rkdotxyz/DM2601/presentation/v1/images/persona.png

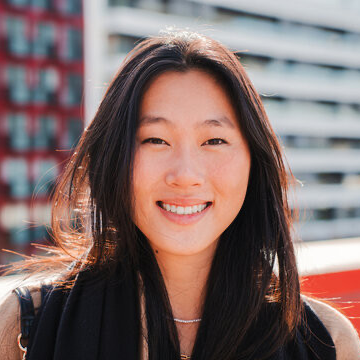
presentation/v1/images/persona.png
