rkdotxyz/DM2601/workbook/README.md

# Workbook

The project workbook for DM2601 will go here as a PDF once it's ready.

It documents the process behind the [presentation](../presentation) and the [prototype](../prototype): research, analysis, ideation and the build.
