rkdotxyz/DM2601/prototype/firmware/heart_doll/heart_doll.ino

/*
  heart_doll.ino  -  Heart Doll firmware (v1.2: its own WiFi, the 3D app)

  A doll with an RGB heart and two buttons:
    Heart  -> tells the phone "I'm available";   heart breathes slowly
    Cross  -> tells the phone "I'm busy";        heart goes dark
  and a phone person who can say Available (heartbeat) or Unavailable.
  Phone available on its own: heartbeat at 60%. Both available, in
  either order: heartbeat at 100%. Each person stays available until
  they change it themselves; Cross means "not now".

  How the files fit together
  --------------------------
    config.h          every setting
    state_machine.h   the rules: (state, event) -> next state
    led.h             draws patterns on the LED
    buttons.h         debounced button presses
    app_link.h        the doll's WiFi, the web server and the WebSocket
    web_page.h        the phone app, built from prototype/app (generated)
    secrets.h         your WiFi name and password (never committed)
    secrets.example.h template: copy it to secrets.h and fill it in
    heart_doll.ino    this file: turns inputs into events, applies the
                      rules, and carries out the effects

  The ESP32 holds the one true state. The phone only sends requests
  and shows what the doll reports back.
*/

#include "config.h"
#include "state_machine.h"
#include "led.h"
#include "buttons.h"
#include "app_link.h"

// The single source of truth.
DollState state = STATE_IDLE;

// Is a phone here, with the app open? And since when has it been gone
// (0 while a phone has it open)?
bool          phoneHere        = false;
unsigned long phoneGoneSinceMs = 0;


// ---------------------------------------------------------------------
// Effects: what each state looks like, and what the phone is told
// ---------------------------------------------------------------------

// Each state has exactly one LED pattern. While no phone is here, the LED
// shows the state as if the phone person had stepped away (the rules
// themselves say what that is): their heartbeat goes, and only the doll
// person's own breathing is left. The state itself is kept, so a phone
// that's back within PHONE_GONE_MS picks up where it left off.
void showState(DollState s) {
  if (!phoneHere) s = nextState(s, EVENT_APP_UNAVAILABLE);
  switch (s) {
    case STATE_IDLE:      ledSetPattern(PATTERN_OFF);       break;
    case STATE_WAITING:   ledSetPattern(PATTERN_BREATHING); break;
    case STATE_CONNECTED: ledSetPattern(PATTERN_HEARTBEAT_SOFT); break;
    case STATE_DECLINED:  ledSetPattern(PATTERN_OFF);            break;
    case STATE_TOGETHER:  ledSetPattern(PATTERN_HEARTBEAT_FULL); break;
  }
}

// Tell the phone the current state, e.g. "status:waiting".
// Sent on every change (and, from Phase 3, whenever a phone connects).
void sendStatus() {
  char message[32];
  snprintf(message, sizeof(message), "status:%s", stateName(state));
  appLinkSend(message);
}


// ---------------------------------------------------------------------
// The one place where events are handled
// ---------------------------------------------------------------------
void handleEvent(DollEvent event) {
  DollState before = state;
  DollState after  = nextState(before, event);   // the rules decide

  // Log it: "[HEART button] idle -> waiting"
  Serial.print("[");
  Serial.print(eventName(event));
  Serial.print("] ");
  Serial.print(stateName(before));
  Serial.print(" -> ");
  Serial.print(stateName(after));
  Serial.println(after == before ? "  (no change)" : "");

  // Button presses are also one-off EVENTS for the phone (it shows a
  // banner), and they get the acknowledgement flash, even when the
  // state doesn't change: pressing Heart twice re-sends "available".
  if (event == EVENT_HEART) {
    appLinkSend("event:heart");
    ledFlash();
  } else if (event == EVENT_CROSS) {
    appLinkSend("event:cross");
    ledFlash();
  }

  // Only a real change updates the LED and the phone's status.
  if (after != before) {
    state = after;
    showState(state);
    sendStatus();
  }
}


// ---------------------------------------------------------------------
// Is a phone here?
// ---------------------------------------------------------------------
// Blue blink while no phone has the app open, and no heartbeat for a phone
// person who isn't there (see showState()). If no phone has been back for
// PHONE_GONE_MS, they've gone for good: that counts as stepping away, and
// the state changes too. Shorter gaps (a reload, a locked screen) only
// change the LED until the phone is back.
void checkPhone(unsigned long now) {
  bool here = appLinkOnline() && appLinkPhones() > 0;
  if (here != phoneHere) {
    phoneHere = here;
    Serial.println(here ? "A phone has the app open." : "No phone has the app open.");
    showState(state);   // with or without the phone person's heartbeat
  }
  ledSetNoPhone(!phoneHere);

  if (phoneHere) {
    phoneGoneSinceMs = 0;
    return;
  }
  if (phoneGoneSinceMs == 0) phoneGoneSinceMs = now ? now : 1;

  bool phonePersonAvailable = (state == STATE_CONNECTED || state == STATE_DECLINED ||
                               state == STATE_TOGETHER);
  if (phonePersonAvailable && now - phoneGoneSinceMs >= PHONE_GONE_MS) {
    Serial.println("No phone for a minute: the phone person has stepped away.");
    handleEvent(EVENT_APP_UNAVAILABLE);
  }
}


// ---------------------------------------------------------------------
// setup() and loop()
// ---------------------------------------------------------------------
void setup() {
  Serial.begin(SERIAL_BAUD);
  delay(500);   // only here: let the USB serial connect

  Serial.println();
  Serial.println("=== Heart Doll v1.2 - its own WiFi ===");

  ledBegin();
  if (BOOT_COLOUR_CHECK) ledColourCheck();
  buttonsBegin();
  appLinkBegin();

  showState(state);
  sendStatus();
}

void loop() {
  unsigned long now = millis();

  // 1. Inputs become events. Nothing here ever waits.
  if (buttonPressed(BUTTON_HEART, now)) handleEvent(EVENT_HEART);
  if (buttonPressed(BUTTON_CROSS, now)) handleEvent(EVENT_CROSS);

  int fromPhone = appLinkReadEvent();
  if (fromPhone >= 0) handleEvent((DollEvent)fromPhone);

  // 2. Network housekeeping (never waits).
  appLinkUpdate(now);
  checkPhone(now);

  // 3. Output: redraw the LED when it's time.
  ledUpdate(now);
}
