rkdotxyz/DM2601/(commit log)

2026-09-15 Build out presentation deck and split into separate files
    Move the deck from a single inline-styled HTML file into index.html,
    styles.css and script.js so the markup stays readable as slides grow.
    Slide work:
    - Add Habit/Routine/Ritual framing slide with comparison table
    - Split target user group into exploring and finalizing slides, using
    scattered notes that narrow to a single focus
    - Add high level ritual domain slide where the decision not to commit to
    a ritual occupies the centre, in place of a chosen one
    - Add persona slide for Marie
    - Drop the agenda slide and the per-slide section numbering
    Slides now cut instantly rather than animate. The one exception is the
    target user group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
2026-09-15 Add research slides and three design directions
    Fill out the middle of the deck with the actual study material and carry
    it through to the directions it produced.
    New slides:
    - Literature review, twelve papers with titles resolved from their DOIs
    - Research findings, thirty observations scattered as a wall of notes
    - Affinity diagramming, those notes clustered into eight themes
    - Three directions to take, plus a scenario, point of view and how might
    we slide for each of phone usage, media consumption and social
    interaction
    The five themes we are not pursuing are muted on the affinity slide so
    the three live ones carry the eye, and those three keep the same order
    everywhere they appear.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
2026-09-15 Trace the double diamond as a progress indicator
    The project is about the double diamond, so the deck now shows where it
    sits in one. A small glyph in the top right carries a grey track with a
    dark line drawn over it, advancing slide by slide.
    Both the upper and lower edges draw at once, so the line visibly spreads
    apart while the work diverges and closes as it converges. It stops just
    short of the waist and holds there, because develop and deliver are work
    this project has not done.
    Each diamond is a square turned 45 degrees rather than the flattened
    shape drawn first, and progress is a stroke along the outline rather
    than a fill, so the diamonds stay unfilled throughout.
    Phase boundarie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
2026-09-29 Back up v1 deck, trim to one direction, add POV/HMW slides
    - Snapshot the current deck at presentation/v1/ so the old version
    stays reachable after the main deck changes.
    - After affinity diagramming, keep only the Social Interaction
    direction; drop the "Three Directions" and the other two direction
    slides.
    - Add standalone POV and HMW slides that speak to just one statement
    each, placed after the Direction slide.
    - Move the double-diamond converge-end marker to the new HMW slide so
    the progress line reaches the diamond intersection there.
2026-09-29 Add line-art icons to brainstorming ideas, add What Next slide
    - Give each of the nine brainstorming cards a small hand-drawn SVG
    icon (puppet, phone, globe, clock, bulb, frame, speaker, ring, AR
    window) so attendees can place the idea at a glance rather than
    reading it cold.
    - Add a "What Next?" slide before the closing slide, laying out the
    remaining ideation work (Crazy 8s, Sketching) and the shortlist step
    that follows.
2026-10-13 Move the heart-doll prototype into the repo
    Copy the local heart-doll project into prototype/ and add an empty
    workbook/ folder for the PDF, so the repo holds the presentation,
    prototype code and workbook together. Real Wi-Fi credentials in
    secrets.h stay local through .gitignore.
2026-10-13 Commit the prototype's secrets.h files
    These hold the Wi-Fi details the firmware uses, kept in the repo so the
    sketches build straight after cloning.
2026-10-13 Clean up the repo and document the prototype for open source
    Stop tracking secrets.h: each Wi-Fi sketch now ships secrets.example.h
    and falls back to it, so a fresh clone builds. Move the test sketches
    into prototype/firmware/tests and drop the empty placeholder files.
    Add READMEs for the repo, presentation, prototype and workbook, plus a
    wiring diagram, parts list, architecture, protocol, build guide, build
    log, gotchas and story for the Heart Doll. License code under MIT and
    everything else under CC BY 4.0.
    Every sketch compiles; with the same secrets.h the firmware builds to
    the same size as before.
2026-10-13 Rebuild the phone app in 3D and publish a demo on GitHub Pages
    A new React + React Three Fiber app in prototype/app/, replacing the look
    of the hand-written page in web_page.h (which the doll still serves; baking
    this app into the firmware comes next):
    - A glass heart joined by glass tubes to the two people. Each person's
    liquid is one number, so it travels down their tube before filling
    their half of the heart, and drains back the same way: the heart never
    holds someone's liquid while their tube is empty.
    - Liquid shaders with a surface that stays level, sloshes with tilt and
    nudges with each heartbeat; a pour from the top, bubbles from the tip.
    - Them is the Heart Doll from the cu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
2026-10-20 Notice at once when a phone vanishes without closing the app
    Switching the phone's WiFi off left its app connection open on the doll,
    so the doll kept counting a phone as here: no blue blink, and the
    one-minute step-away never started. Now the doll pings a quiet
    connection every 2 s and closes it after 6 s without an answer, and on
    its own network closes every app connection as soon as no phone is left
    on its WiFi.
2026-10-20 Give the app the website's soft look, add music to the website, drop night mode
    App (prototype/app):
    - The customiser website's palette, type (Fraunces and Inter, bundled for
    the doll's offline page), icon buttons, chips and state card.
    - Softer 3D: frosted-glass heart and tubes instead of shiny reflective
    glass, the website's studio lighting and paper background, matte
    porcelain pedestals with ground shadows, a matte blush locket frame,
    the doll in its heather-grey fabric, and the website's crimson liquid.
    - The demo page laid out like the customiser: scene left, panel right.
    - web_page.h rebuilt for the doll (484 KB gzipped, 47% of Huge APP).
    Website:
    - Background music: "Soundtra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
2026-10-20 Route your tube round the locket, not behind your photo
    The tube from your pedestal ran up behind the locket, so its top showed
    just above the frame and looked like it came out of the photo's head.
    It now leaves the pedestal's left edge and curves round the left of the
    locket into the heart's tip. web_page.h rebuilt for the doll.
2026-10-20 Attach your tube to the back of the locket, zigzag like the top one
    The side loop round the locket looked random. Now the tube is fixed to
    the back of your locket, rises behind it, comes out above the frame and
    zigzags up into the heart's tip, mirroring the top tube. Your pedestal
    sits a little lower to make room, and the camera frame is refitted.
    web_page.h rebuilt for the doll.
